ssagerian/OnStepHardware/Hardware/designfiles/gerbers/OnStep.TXT

%
M48
M72
T01C0.0236
T02C0.0240
T03C0.0276
T04C0.0400
T05C0.0551
T06C0.0591
T07C0.1260
%
T01
X17560Y8693
X18560Y9693
X16560Y9693
X18360Y17393
X19360Y18393
X17360Y18393
T02
X7960Y5393
X7660Y7493
X9360Y7393
X11000Y8803
X11030Y9303
X11740Y9333
X11760Y8813
X12560Y7593
X13560Y7593
X13560Y8293
X13860Y8793
X14860Y9293
X14790Y9953
X14910Y10533
X14860Y11093
X14860Y11793
X14860Y12493
X13370Y12133
X12060Y11833
X11390Y11843
X10360Y11693
X9360Y12593
X7660Y11493
X4970Y11533
X6670Y13433
X4970Y13733
X4970Y15533
X8160Y17393
X10160Y17593
X11740Y18343
X12440Y18343
X12440Y18843
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
