ssagerian/OnStepHardware/Hardware/bom/OnstepRevC_BOM.xlsx

Sheet: Rev C 30 piece build
Build Quantity | 10
Part | Value | Quantity Per Board | Quantity Per Build | Manufacture | Manufacture PN | Digikey | Package | Description
C1,C2 | 10nF 50V | 2 | 20 | TDK | CGA4C2C0G1H103J060AA | 445-6947-1-ND | C0805 | CAPACITOR, American symbol
C3,C4,C5,C6,C8 | 0.1uf 50V | 5 | 50 | Kemet | C0805C104K5RACTU | 399-1170-1-ND | C0805 | CAPACITOR, American symbol
C16,C17 | 0.47uf 16V | 2 | 20 | Kemet | C0805C474K4RACTU | 399-8099-1-ND (http://www.digikey.com/product-detail/en/C0805C474K4RACTU/399-8099-1-ND/3471822) | C0805 | CAPACITOR, American symbol
C7 | 100uF | 1 | 10 | Pansonic | EEE-FK1J101P | PCE3819CT-ND | PANASONIC_G | POLARIZED CAPACITOR, American symbol
C9 | 10uf | 1 | 10 | Samsung | CL21A106KAYNNNE | 1276-2891-1-ND | C0805
CN3 |  | 1 | 10 | JST Sales | B2B-PH-K-S(LF)(SN) | 455-1704-ND
CONN1 |  | 1 | 10 | Wurth | 691216510002 | 732-2749-ND
CONN2 |  | 1 | 10 | JST Sales | B3B-PH-K-S(LF)(SN) | 455-1705-ND
D1,D2,D3,D5 |  | 4 | 40 | Diodes Inc | 1N4148WS-7-F | 1N4148WS-FDICT-ND | SOD323-W | DIODE
FUSE1 |  | 1 | 10 | Keystone | 3588 | 3588K-ND | MINI_FUSE_HOLDER_SMT
LED1 | Blue | 1 | 10 | Wurth | 150080BS75000 | 732-4982-1-ND | LED0805
LED2,LED3 | RED | 2 | 20 | Wurth | 150080RS75000 | 732-4984-1-ND | CHIPLED_0805 | LED
PHEONIX1,PHEONIX2 |  | 2 | 20 | Wurth | 691311500104 | 732-2060-ND
R1,R2 | 330 | 2 | 20 | Pansonic | ERJ-6ENF3300V | P330CCT-ND | R0805 | RESISTOR, American symbol
R3,R4,R5,R6 | 0.2 | 4 | 40 | Pansonic | ERJ-S6SFR20V | P.2BJCT-ND | R0805 | RESISTOR, American symbol
R7 | 220 | 1 | 10 | Pansonic | ERJ-6ENF2200V | P220CCT-ND | R0805 | RESISTOR, American symbol
R9,R11,R12,R13,R14,R16,R16,R17,R20 | 10K CHIP | 8 | 80 | Pansonic | ERJ-6ENF1002V | P10KACT-ND | R0805
R21 | 102K | 1 | 10 | Pansonic | ERJ-6ENF1023V | P102KCCT-ND | R0805
R8,R10 | 10K POT | 2 | 20 | Bourns | 3362P-1-103LF | 3362P-103LF-ND | 10K trimmer Pot
R18,R19 | 1MEG | 2 | 20 | Pansonic | ERJ-6ENF1004V | P1.00MCCT-ND | R0805 | RESISTOR, American symbol
U2,U4 |  | 2 | 20 | TI | DRV8825PWPR | 296-29503-1-ND | 28 PIN HTSSOP
U3 |  | 1 | 10 | Microchip | RN42 | 740-1038-ND | RN42QFN
Plug for RA and DEC |  | 2 | 20 | Wurth | 691351500004 | 732-2042-ND
58V 5 A fuse |  | 1 | 10 | Little Fuse Inc | 0997005.WXN | F1873-ND | mini fuse
D4 |  | 1 | 10 | Diodes Inc | B2100-13-F | B2100-FDICT-ND | D0-214AA SMB
U6 | switching ps | 1 | 10 | Microchip | MCP16331T-E | MCP16331T-E/CHCT-ND
L1 | inductor | 1 | 10 | Wurth | 7447779147W | 732-4272-1-ND
D6 | 7.5V Zener | 1 | 10 | Diodes Inc | MMSZ5236BS-7-F | MMSZ5236BS-FDICT-ND | SOD323

Sheet: Rev B 10 piecebuild
Build Quantity | 10
Part | Value | Quantity Per Board | Quantity Per Build | Digikey | Unit Cost | Cost | Discounted Cost per 10 | Total Build Cost | Discounted Cost | Package | Description
C1,C2 | 10nF 50V | 2 | 20 | 445-6947-1-ND | 0.32 | 0.64 | 0.269 | 6.4 | 2.69 | C0805 | CAPACITOR, American symbol
C3,C4,C5,C6 | 0.1uf 50V | 4 | 40 | 399-1170-1-ND | 0.1 | 0.4 |  | 4 |  | C0805 | CAPACITOR, American symbol
C16,C17 | 0.47uf 16V | 2 | 20 | 399-8099-1-ND (http://www.digikey.com/product-detail/en/C0805C474K4RACTU/399-8099-1-ND/3471822) | 0.21 | 0.42 |  | 4.2 |  | C0805 | CAPACITOR, American symbol
CN3 |  | 1 | 10 | 455-1704-ND | 0.16 | 0.16 |  | 1.6 |  | B2B-PH
CONN1 |  | 1 | 10 | A98342-ND | 1.05 | 1.05 |  | 10.5 |  | PHOENIX2
CONN2 |  | 1 | 10 | 455-1705-ND | 0.18 | 0.18 |  | 1.8 |  | B3B-PH
D1,D2,D3 |  | 3 | 30 | 1N4148WS-FDICT-ND | 0.18 | 0.54 |  | 5.4 |  | SOD323-W | DIODE
FUSE1 |  | 1 | 10 | 3588K-ND | 1.35 | 1.35 |  | 13.5 |  | MINI_FUSE_HOLDER_SMT
LED1 | Blue | 1 | 10 | 160-1645-1-ND | 0.44 | 0.44 |  | 4.4 |  | LED0805
LED2,LED3 | RED | 2 | 20 | 732-4984-1-ND | 0.29 | 0.58 |  | 5.8 |  | CHIPLED_0805 | LED
PC2 | 100uF | 1 | 10 | PCE4904CT-ND | 2.38 | 2.38 |  | 23.8 |  | PANASONIC_G | POLARIZED CAPACITOR, American symbol
PHEONIX1,PHEONIX2 |  | 2 | 20 | 277-1152-ND | 1.22 | 2.44 |  | 24.4 |  | PHENIOX
R1,R2 | 330 | 2 | 20 | RHM330CHCT-ND | 0.1 | 0.2 |  | 2 |  | R0805 | RESISTOR, American symbol
R3,R4,R5,R6 | 0.2 | 4 | 40 | 1276-6171-1-ND | 0.21 | 0.84 |  | 8.4 |  | R0805 | RESISTOR, American symbol
R7 | 220 | 1 | 10 | P220CCT-ND | 0.1 | 0.1 |  | 1 |  | R0805 | RESISTOR, American symbol
R9,R11,R12,R13,R14,R16,R16,R17 | 10K CHIP | 8 | 80 | P10KACT-ND | 0.1 | 0.8 |  | 8 |  | BOURN3362P
R8,R10 | 10K POT | 2 | 20 | 3362P-103LF-ND | 1.02 | 2.04 |  | 20.4 |  | BOURN3362P
R18,R19 | 1MEG | 2 | 20 | RHM1.0MKCT-ND | 0.1 | 0.2 |  | 2 |  | R0805 | RESISTOR, American symbol
U1 | ARDUINO-MEGAFULL |  | 0 |  |  | 0 |  | 0 |  | ARDUINO_MEGA | Arduino Mega board footprint
U2,U4 |  | 2 | 20 | 296-29503-1-ND | 6.22 | 12.44 |  | 124.4 |  | DRV8825
U3 |  | 1 | 10 | 740-1038-ND | 18.22 | 18.22 |  | 182.2 |  | RN42QFN
Plug for Pheonix |  | 2 | 20 | 277-1013-ND | 3.29 | 6.58 |  | 65.8
58V 7.25 A fuse |  | 1 | 10 | F5005-ND | 0.86 | 0.86 | 0.783 | 8.6 | 7.83
 |  |  |  |  | Total Per Board | 5.286 |  | 52.86
 |  |  |  | A98070-ND | 4.6 | 10.07
 |  |  |  |  | 8.67
