ssagerian/OnStepHardware/Hardware/schematic/OnStep.pdf

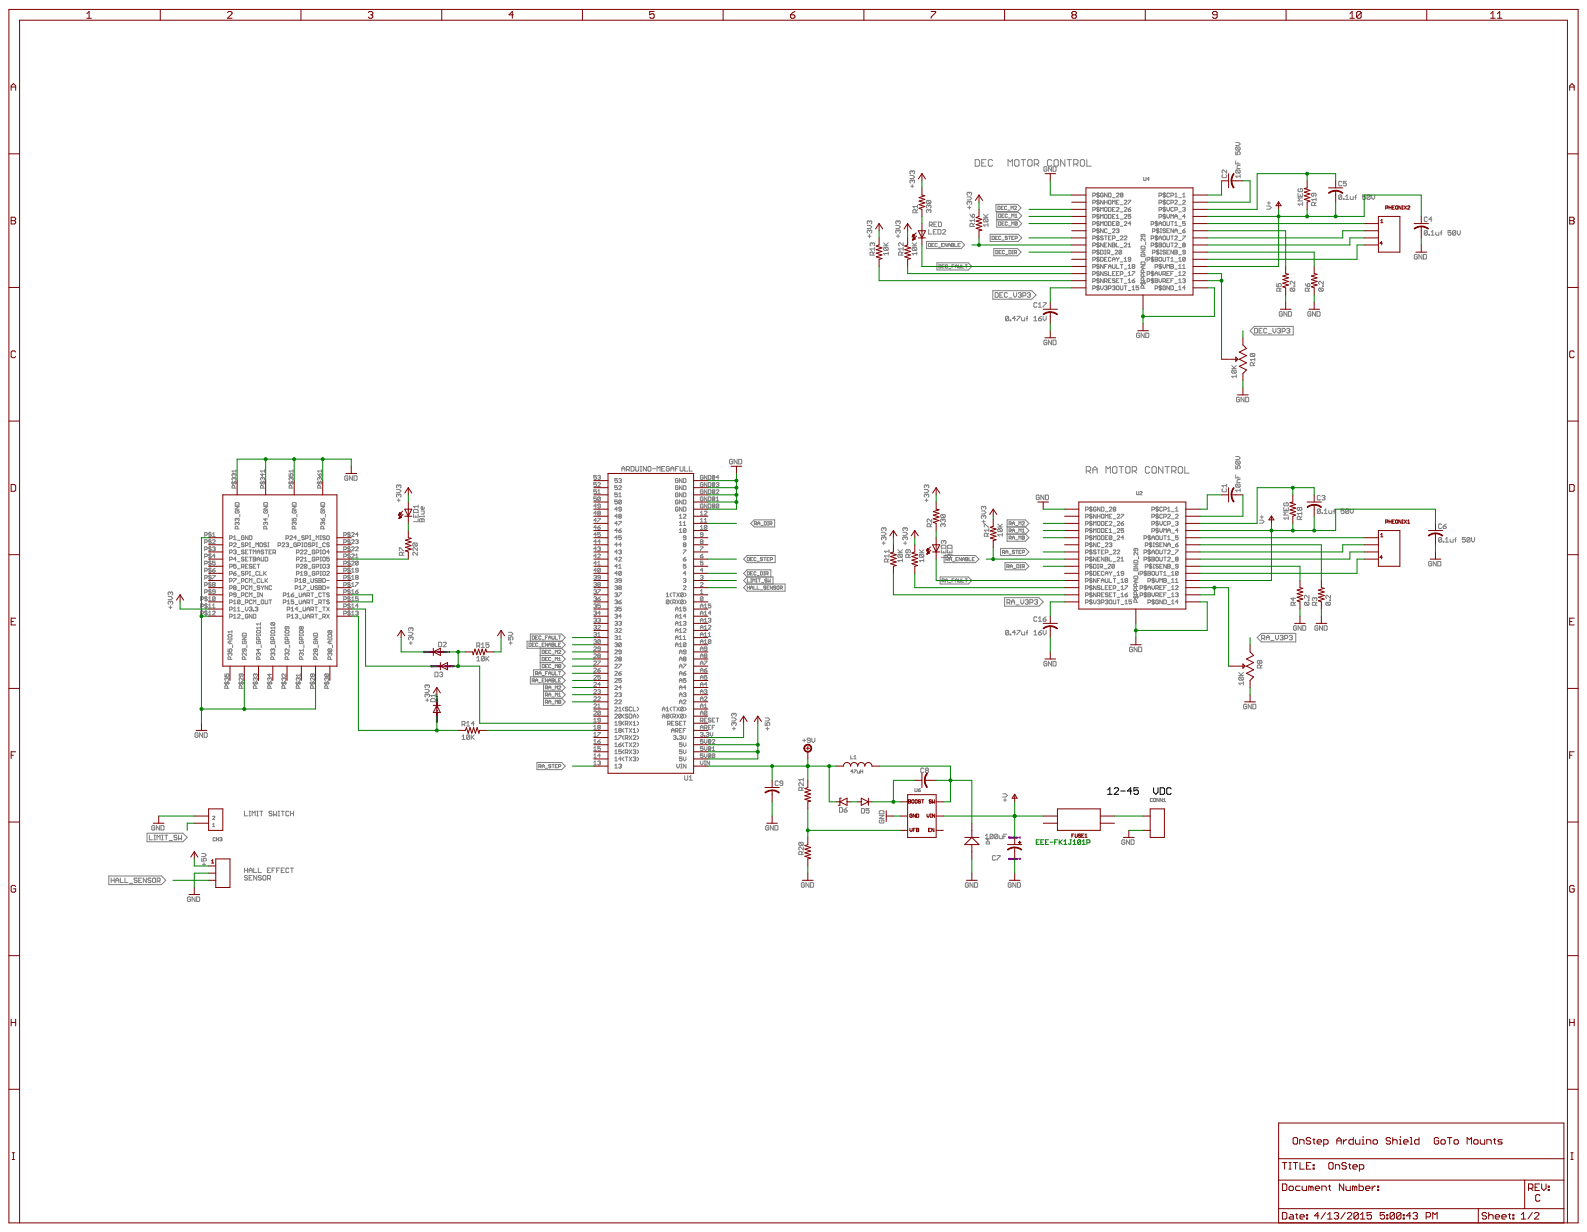
[picture p1: page 1]
