ssagerian/OnStepHardware/Hardware/designfiles/OnStep.brd

## EAGLE design Hardware/designfiles/OnStep.brd (2015-06-29)

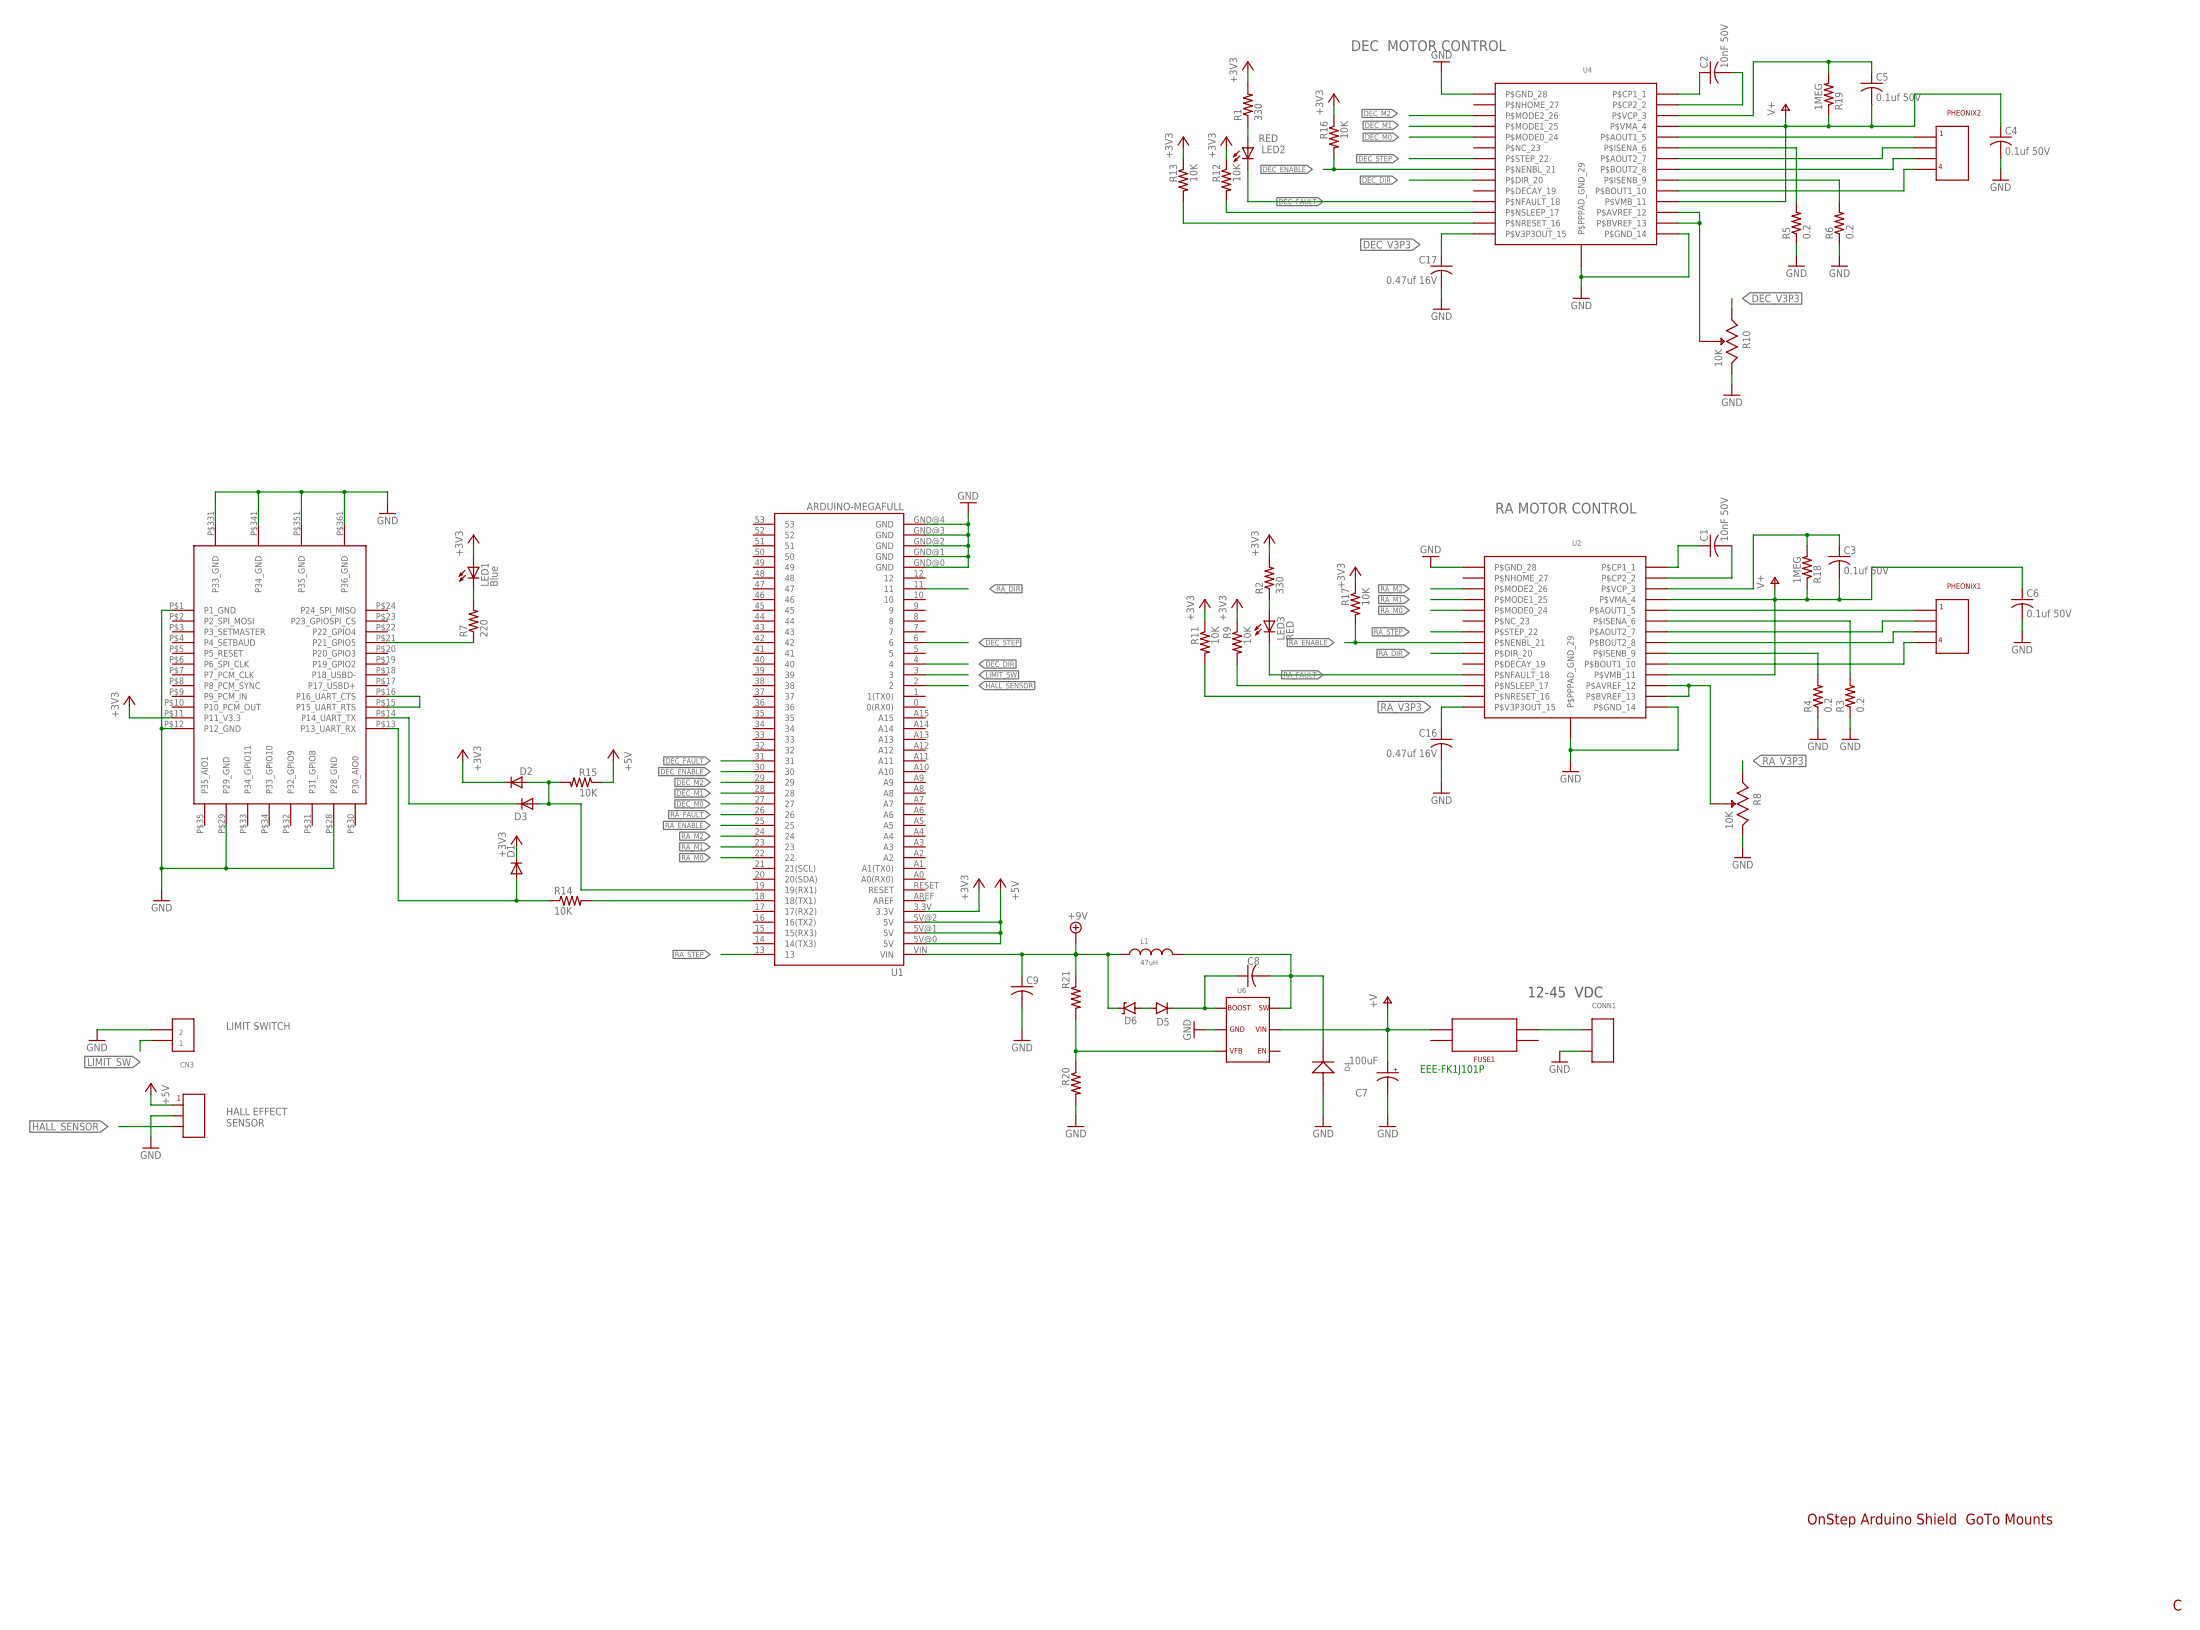
[picture p2: schematic OnStep.sch, sheet 1]

Parts:
C1, C2: 10nF 50V; C0805
C3, C4, C5, C6: 0.1uf 50V; C0805
C7: 100uF; PANASONIC_G
C8: 100nf; C0805
C9: 10uf 0805 x5r; C0805
C16, C17: 0.47uf 16V; C0805
CN3: B2B-PH
CONN1: PHEONIX2; PHOENIX2
CONN2: B3B-PH
D1, D2, D3: 1N4148; SOD323-W
D4: B2100; SMB
D5: 1N4148; SOD-323
D6: 7.3V; SOD-323
FUSE1: MINI_FUSE_SMT; MINI_FUSE_HOLDER_SMT
L1: 47uH; WURTH_7MMX7MM_INDUCTOR
LED1: Blue; LED0805
LED2, LED3: RED; CHIPLED_0805
PHEONIX1, PHEONIX2: PHEONIX_4PIN; PHENIOX
R1, R2: 330; R0805
R3, R4, R5, R6: 0.2; R0805
R7: 220; R0805
R8, R10: 10K; BOURN3362P
R9, R11, R12, R13, R14, R15, R16, R17, R20: 10K; R0805
R18, R19: 1MEG; R0805
R21: 102K 1%; R0805
U1: ARDUINO-MEGAFULL; ARDUINO_MEGA
U2, U4: DRV8825
U3: RN42QFP; RN42QFN
U6: MCP16331; SOT23-6

Connections:
+3V3: D1.C, D2.C, LED1.1 (A), R1.2, R2.2, R9.1, R11.1, R12.1, R13.1, R16.1, R17.1, U1.3.3V, U3.P$11 (P11_V3.3)
+5V: CONN2.P$1, R15.1, U1.5V@0 (5V), U1.5V@1 (5V), U1.5V@2 (5V)
+9V: C9.1, D6.C, L1.P$1, R21.1, U1.VIN
+24V: C3.2, C4.1, C5.2, C6.1, C7.+, FUSE1.P$1, R18.1, R19.1, U2.P$4 (P$VMA_4), U2.P$11 (P$VMB_11), U4.P$4 (P$VMA_4), U4.P$11 (P$VMB_11), U6.5
DEC_A1: PHEONIX2.P$1, U4.P$5 (P$AOUT1_5)
DEC_A2: PHEONIX2.P$2, U4.P$7 (P$AOUT2_7)
DEC_B1: PHEONIX2.P$4, U4.P$10 (P$BOUT1_10)
DEC_B2: PHEONIX2.P$3, U4.P$8 (P$BOUT2_8)
DEC_DIR: U1.4, U4.P$20 (P$DIR_20)
DEC_ENABLE: R16.2, U1.30, U4.P$21 (P$NENBL_21)
DEC_FAULT: LED2.C, U1.31, U4.P$18 (P$NFAULT_18)
DEC_M0: U1.27, U4.P$24 (P$MODE0_24)
DEC_M1: U1.28, U4.P$25 (P$MODE1_25)
DEC_M2: U1.29, U4.P$26 (P$MODE2_26)
DEC_STEP: U1.6, U4.P$22 (P$STEP_22)
DEC_V3P3: C17.1, R10.P$1, U4.P$15 (P$V3P3OUT_15)
GND: C4.2, C6.2, C7.-, C9.2, C16.2, C17.2, CN3.P$2, CONN1.P$3, CONN2.P$2, D4.A, R3.1, R4.1, R5.1, R6.1, R8.P$3, R10.P$3, R20.2, U1.GND@0 (GND), U1.GND@1 (GND), U1.GND@2 (GND), U1.GND@3 (GND), U1.GND@4 (GND), U2.P$14 (P$GND_14), U2.P$28 (P$GND_28), U2.P$29 (P$PPPAD_GND_29), U3.P$1 (P1_GND), U3.P$12 (P12_GND), U3.P$28 (P28_GND), U3.P$29 (P29_GND), U3.P$331 (P33_GND), U3.P$341 (P34_GND), U3.P$351 (P35_GND), U3.P$361 (P36_GND), U4.P$14 (P$GND_14), U4.P$28 (P$GND_28), U4.P$29 (P$PPPAD_GND_29), U6.2
HALL_SENSOR: CONN2.P$3, U1.2
LIMIT_SW: CN3.P$1, U1.3
unnamed: R14.2, U1.18 (18(TX1))
unnamed: C1.1, U2.P$1 (P$CP1_1)
unnamed: C1.2, U2.P$2 (P$CP2_2)
unnamed: R20.1, R21.2, U6.3
unnamed: R12.2, U4.P$17 (P$NSLEEP_17)
unnamed: R13.2, U4.P$16 (P$NRESET_16)
unnamed: R11.2, U2.P$16 (P$NRESET_16)
unnamed: R9.2, U2.P$17 (P$NSLEEP_17)
unnamed: LED3.A, R2.1
unnamed: R3.2, U2.P$6 (P$ISENA_6)
unnamed: R4.2, U2.P$9 (P$ISENB_9)
unnamed: LED2.A, R1.1
unnamed: C8.1, D5.C, U6.1
unnamed: D5.A, D6.A
unnamed: R5.2, U4.P$6 (P$ISENA_6)
unnamed: R6.2, U4.P$9 (P$ISENB_9)
unnamed: C2.1, U4.P$1 (P$CP1_1)
unnamed: C2.2, U4.P$2 (P$CP2_2)
unnamed: C3.1, R18.2, U2.P$3 (P$VCP_3)
unnamed: C5.1, R19.2, U4.P$3 (P$VCP_3)
unnamed: R10.P$2, U4.P$12 (P$AVREF_12), U4.P$13 (P$BVREF_13)
unnamed: R8.P$2, U2.P$12 (P$AVREF_12), U2.P$13 (P$BVREF_13)
unnamed: D1.A, R14.1, U3.P$13 (P13_UART_RX)
unnamed: C8.2, D4.C, L1.P$2, U6.6
unnamed: D3.C, U3.P$14 (P14_UART_TX)
unnamed: D2.A, D3.A, R15.2, U1.19 (19(RX1))
unnamed: U3.P$15 (P15_UART_RTS), U3.P$16 (P16_UART_CTS)
unnamed: LED1.2 (C), R7.2
unnamed: R7.1, U3.P$21 (P21_GPIO5)
RA_A1: PHEONIX1.P$1, U2.P$5 (P$AOUT1_5)
RA_A2: PHEONIX1.P$2, U2.P$7 (P$AOUT2_7)
RA_B1: PHEONIX1.P$4, U2.P$10 (P$BOUT1_10)
RA_B2: PHEONIX1.P$3, U2.P$8 (P$BOUT2_8)
RA_DIR: U1.11, U2.P$20 (P$DIR_20)
RA_ENABLE: R17.2, U1.25, U2.P$21 (P$NENBL_21)
RA_FAULT: LED3.C, U1.26, U2.P$18 (P$NFAULT_18)
RA_M0: U1.22, U2.P$24 (P$MODE0_24)
RA_M1: U1.23, U2.P$25 (P$MODE1_25)
RA_M2: U1.24, U2.P$26 (P$MODE2_26)
RA_STEP: U1.13, U2.P$22 (P$STEP_22)
RA_V3P3: C16.1, R8.P$1, U2.P$15 (P$V3P3OUT_15)
V+: CONN1.P$2, FUSE1.P$3

Notes on the sheet:
12-45 VDC
RA MOTOR CONTROL
DEC MOTOR CONTROL
LIMIT SWITCH
HALL EFFECT SENSOR
OnStep Arduino Shield GoTo Mounts
EEE-FK1J101P

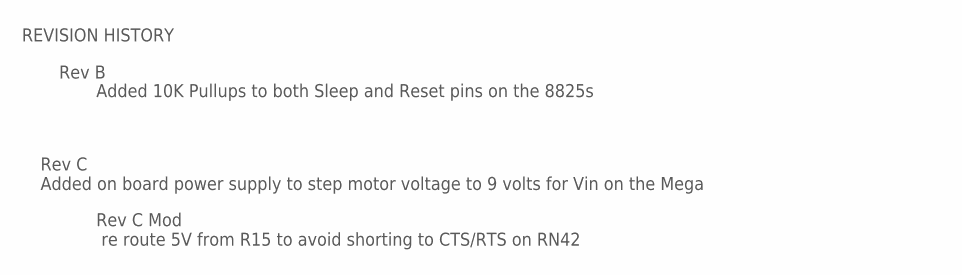
[picture p3: schematic OnStep.sch, sheet 2]

Notes on the sheet:
REVISION HISTORY
Added 10K Pullups to both Sleep and Reset pins on the 8825s
Rev B
Rev C Added on board power supply to step motor voltage to 9 volts for Vin on the Mega
Rev C Mod re route 5V from R15 to avoid shorting to CTS/RTS on RN42

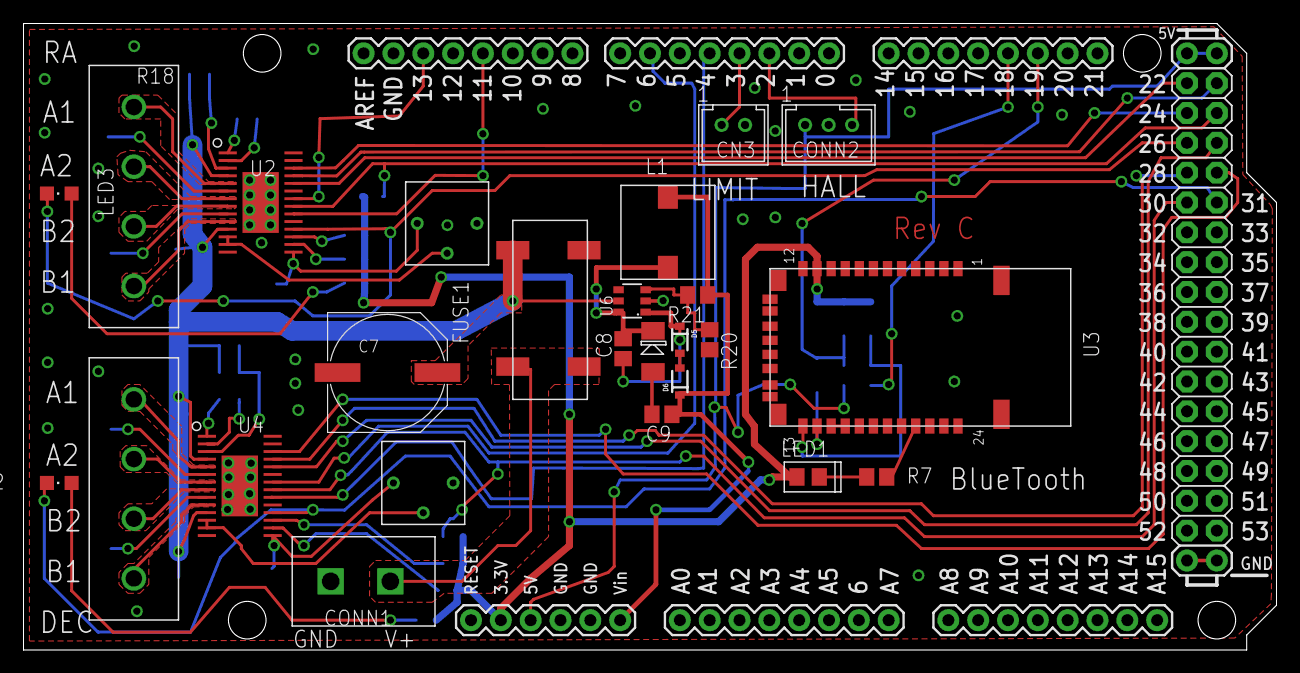
[picture p4: board OnStep.brd from above]

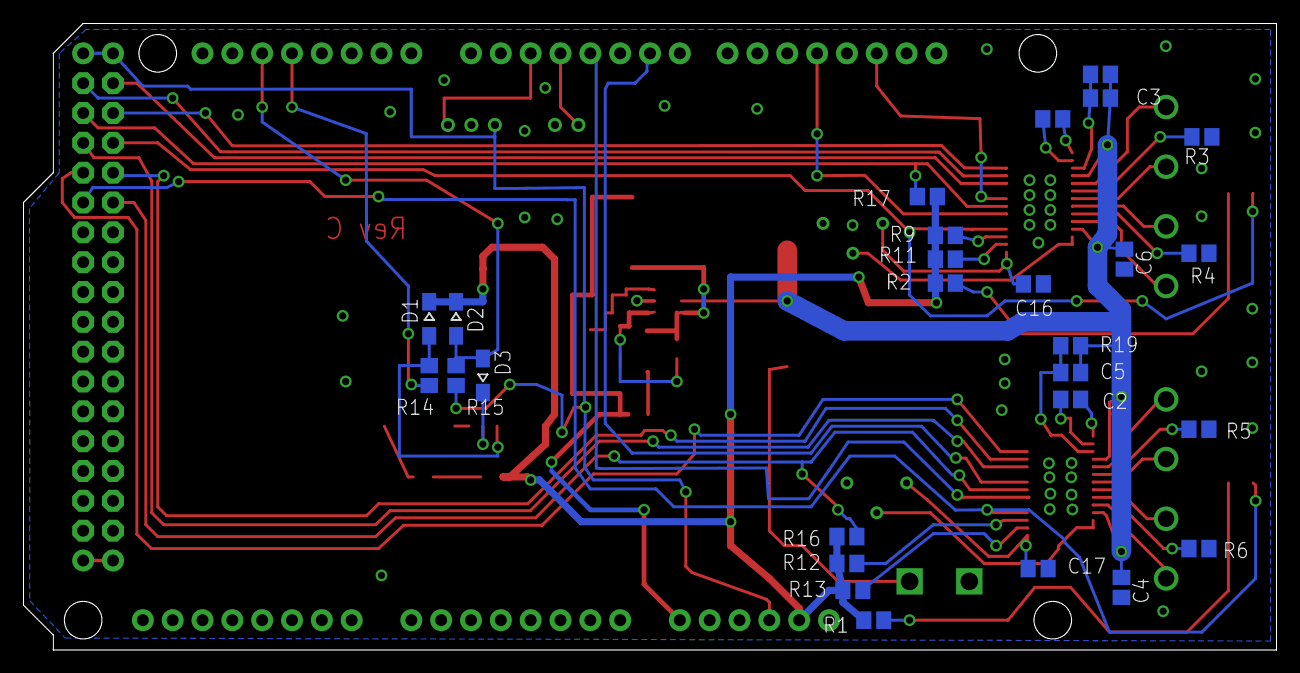
[picture p5: board OnStep.brd from below]

Board: 2 copper layers, 106.7 x 53.3 mm, 53 parts (27 on the bottom side), 61 nets.
